penoel/Basic-Levitator/README.md

# Basic-Levitator
Two 40 kHz transducers that create a standing wave when positioned above each other.  They are driven with a 555 timer in astable mode.  A 3d printed part with a threaded heat insert is used to secure it to the board.
