penoel/Basic-Levitator/New_transducerholder.stl

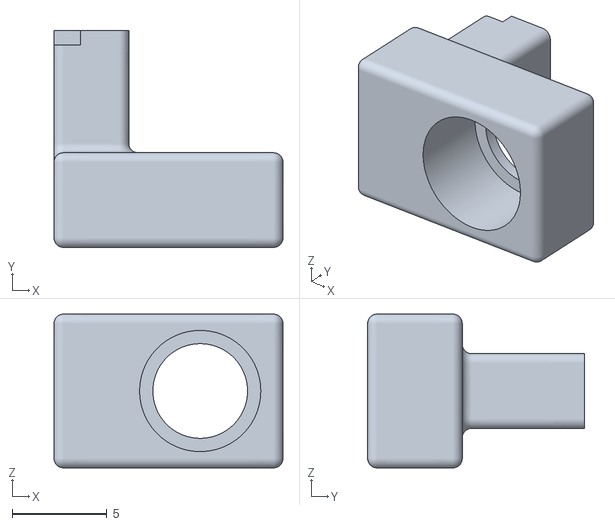
[picture p3: CAD file, 2019-06-27]
New_transducerholder.stl
12.1 x 11.4 x 8.12
