penoel/Basic-Levitator/transducerholder.stl

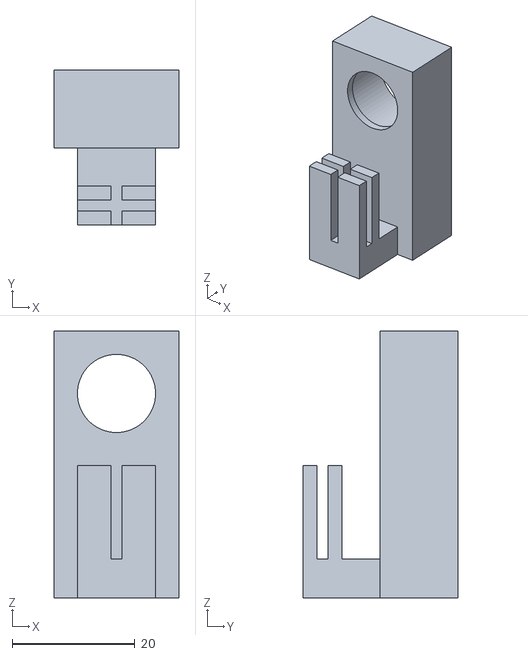
[picture p4: CAD file, 2018-05-11]
transducerholder.stl
20.3 x 25.2 x 43.4
