penoel/Basic-Levitator/basic levitator.brd

## EAGLE design basic levitator.brd (2018-05-11)

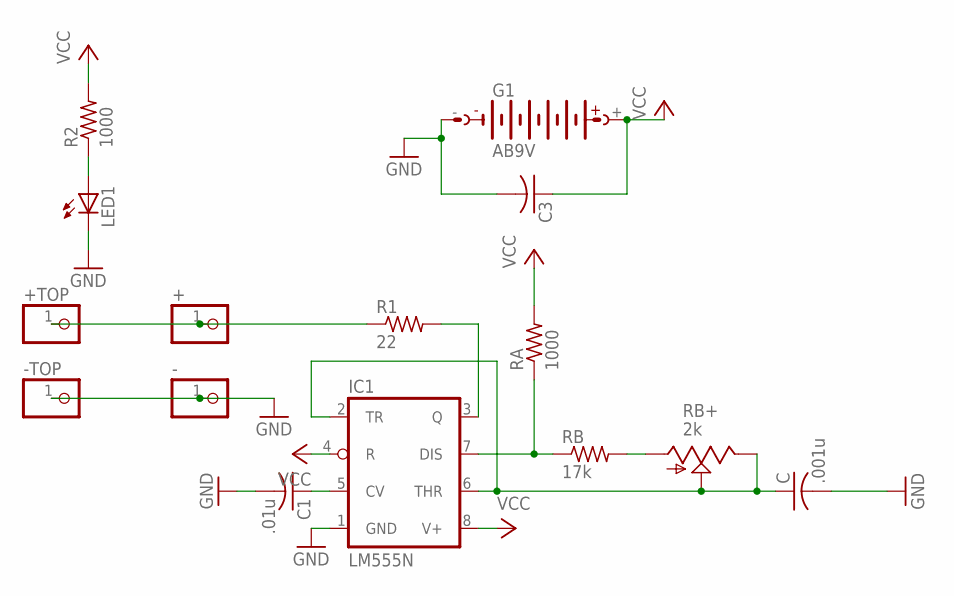
[picture p5: schematic basic levitator.sch]

Parts:
+: PINHD-1X1; 1X01
+TOP: PINHD-1X1; 1X01
-: PINHD-1X1; 1X01
-TOP: PINHD-1X1; 1X01
C: .001u; C025-024X044
C1: .01u; C025-025X050
C3: C-US050-024X044; C050-024X044
G1: AB9V
IC1: LM555N; DIL08
LED1: LED3MM
R1: 22; 0207/10
R2: 1000; 0207/10
RA: 1000; 0207/10
RB: 17k; 0207/10
RB+: 2k; CA6V

Connections:
GND: -.1, -TOP.1, C.2, C1.2, C3.2, G1.-, IC1.1 (GND), LED1.K (C)
unnamed: LED1.A, R2.1
unnamed: C1.1, IC1.5 (CV)
unnamed: C.1, IC1.2 (TR), IC1.6 (THR), RB+.E, RB+.S
unnamed: IC1.7 (DIS), RA.1, RB.1
unnamed: IC1.3 (Q), R1.2
unnamed: +.1, +TOP.1, R1.1
unnamed: RB.2, RB+.A
VCC: C3.1, G1.+, IC1.4 (R), IC1.8 (V+), R2.2, RA.2

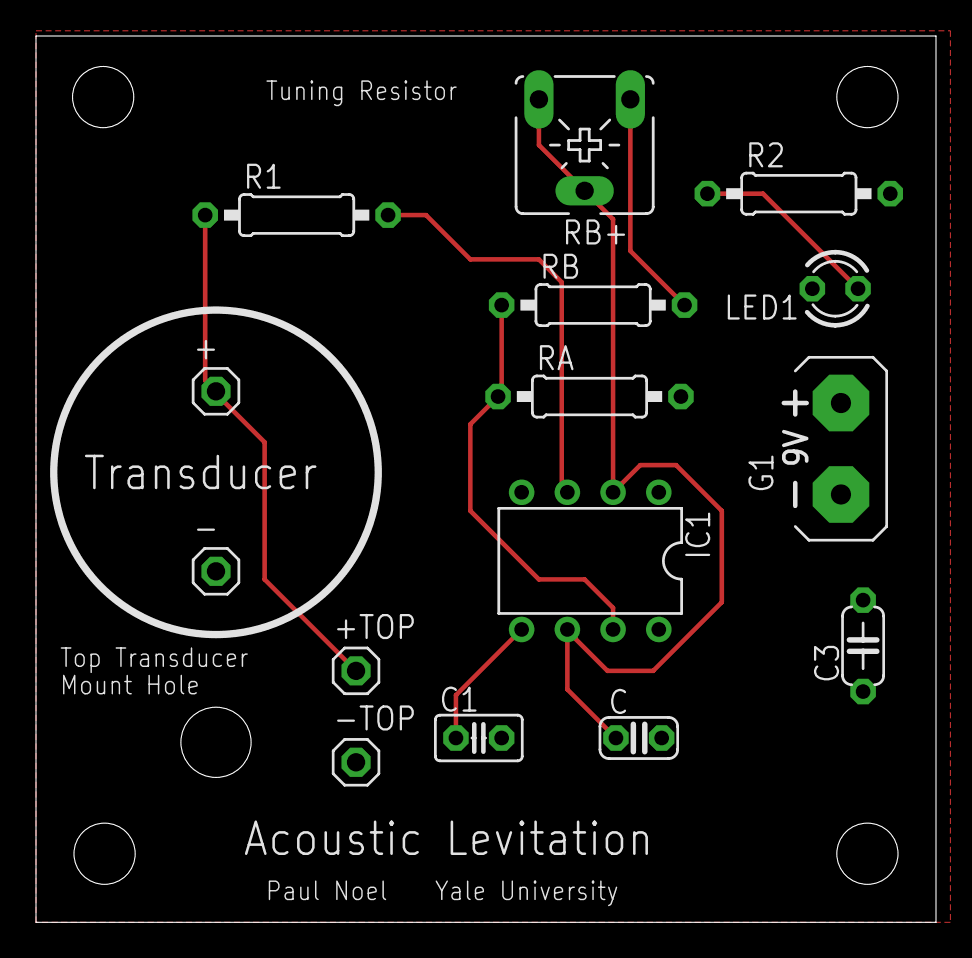
[picture p6: board basic levitator.brd from above]

Board: 2 copper layers, 50.0 x 49.2 mm, 15 parts (0 on the bottom side), 9 nets.
